ItsTonyMei/6wd-follower-esp32-openmv/STM32_Solo/STM32引脚定义图.jpg

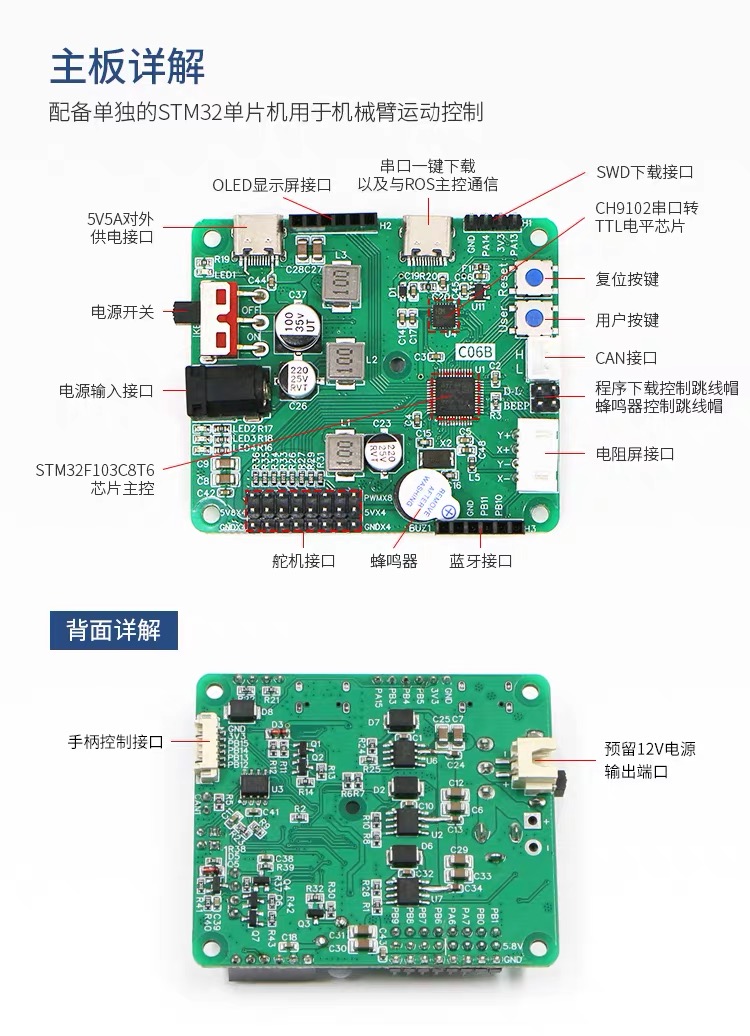
STM32_Solo/STM32引脚定义图.jpg
