ItsTonyMei/6wd-follower-esp32-openmv/STM32_Solo/C06B主板原理图_分析.md

# C06B 主板原理图 — 完整分析文档

> **元数据**
> - 文件名：C06B主板原理图.pdf
> - 页数：1 页 (Sheet 1/1)
> - 版本：REV 1.0
> - 作者：minibalance
> - 日期：2021-05-13
> - 图纸尺寸：1500 × 1300.5 pts
> - 生成工具：jsPDF 0.0.0
>
> **分析方法说明**：本文档通过 `pdftotext -layout` 提取 PDF 文本后人工判读。原理图由 EDA 工具导出为 jsPDF，pdftotext 提取结果为 ASCII-art 布局文本，元件名和网络名的空间位置近似反映原图布局，但存在偏移。**以下内容的置信度分级**：
> - ✅ 高置信度：直接标注文字（芯片型号、网络名如 3V3/GND/5V、功能块标签、"板载5V电路"等）
> - ⚠️ 中置信度：通过空间邻近关系推断的连接（如 MCU 引脚→外设接口的具体 pin 号）
> - ❌ 低置信度：涉及多位号交叉对照的连接（建议对照 PCB 或原始 PDF 确认）

---

## 1. 系统总览

C06B 是一块基于 **STM32F103C8T6**（或同系列 48 脚 LQFP 封装）的主控板，集成了多路电源、USB-C 通信/供电、CAN 总线、蓝牙、OLED 显示、PS2 手柄、8 路舵机驱动、蜂鸣器、轻触按键等功能。原理图采用 7 列网格布局（A-F 行 × 1-7 列），便于在单页中容纳所有模块。

**主控芯片识别依据**：
- 48 脚 LQFP 封装（VSS_1@23, VDD_1@24, VSS_2@35, VDD_2@36, VSS_3@47, VDD_3@48）
- PA0-PA15, PB0-PB15, PC13-PC15 引脚分布符合 STM32F103Cx 系列
- BOOT0@44, BOOT1/PB2@20, NRST@7
- OSCIN/OSCOUT (PD0/PD1) @5-6，外接 8MHz 晶振 + 22pF 负载电容
- VBAT@1 外接 3V3（非电池供电）

---

## 2. 电源树 (Power Tree)

### 2.1 输入电源

| 来源 | 接口 | 电压 | 备注 |
|---|---|---|---|
| DC 母座 | DC-005A-20A (J3) | 外部直流输入 | 经电源开关 (CN1: VIN → VIN_SW) |
| USB-C #1 | USBC1 (USB3.1C16PFSMT) | 5V VBUS | 支持 USB PD? (有 CC1/CC2 引脚) |
| USB-C #2 | USBC3 (USB3.1C16PFSMT) | 5V VBUS | 同上 |

**电源开关**：CN1 (2.54-2P WT) — VIN 经开关后输出 VIN_SW，控制整板供电。

### 2.2 DC-DC 降压电路 (3 路 RT8279GSP)

C06B 使用 **3 颗 Richtek RT8279GSP** 同步降压转换器，分别输出 3 路独立电压：

| 编号 | 输出 | 电感 | 备注 | 用途 | 位置 |
|---|---|---|---|---|---|
| U2 | **5V** (板载5V电路) | L1, 6.8μH | 反馈网络在列5，原文可见 R10=12.4k(1%), R1=10k(1%), R28=3.16k。注意：10k/3.16k 按 RT8279 Vref=0.808V 算出约 3.4V 非 5V——这些可能为补偿 RC 网络 (Rcomp+10nF)，不是反馈分压电阻。实际反馈电阻值需对照 PCB 或更高清原理图确认。 | 主系统 5V 供电 | 列 5 上部 |
| U7 | **5.8V** (板载5.8V电路) | L2, 6.8μH | R2=10k(1%), R6=10k(1%), R7=1k(1%) 在原文中可见于列2区域。同上，具体反馈分压值待确认。 | 舵机电源 | 列 2 上部 |
| U6 | **5V5A** (树莓派5V电路) | L3, 6.8μH | R24=10k(1%), R25=3.16k, R19=1k 可见于列1区域。同上。 | 外部大电流 5V 输出 | 列 1 下部 |

**典型外围**（每路相同）：
- 输入电容：22μF/25V × 2 + 4.7μF + 0.1μF
- 输出电容：22μF/25V × 2 + 0.1μF
- 输出滤波：磁珠 FB1/FB2/FB (用于 EMI)
- EN 引脚：使能控制（具体连接取决于电路）
- 续流二极管：SS54 (Schottky, 5A/40V)

**RT8279GSP 封装**：SOP-8 (EP)，带底部散热焊盘 (PAD)

### 2.3 LDO 电路

| 编号 | 芯片 | 输入 | 输出 | 用途 |
|---|---|---|---|---|
| U11 | RT9013-33GB | 5V (经 F1 自恢复保险) | **3V3** | MCU 及数字电路供电 |
| - | - | VIN_SW | 3V3 (经 LDO) | 另一路 3V3? |

> **F1**：BSMD0603-050-6V，0603 封装 500mA 自恢复保险丝，保护 5V→3.3V LDO 输入。

**3.3V 保护**：
- D8：SMBJ3.3A TVS 管，防止 3.3V 总线上过压/ESD

### 2.4 电源滤波/去耦

- 各 DC-DC 输出端均有 **220μF/16V** 大容量电解电容 (C10/C26)
- 各模块就近放置 0.1μF + 10μF 去耦
- C13/C29/C33/C34/C48: 22μF/25V 输入滤波
- C12: 22μF/25V

### 2.5 输出接口

- **H4-H7** (HDR-F-2.54_1x3 × 4)：**5V 输出**，信号来自 PB6-PB9（经 220Ω 限流电阻 R26/R27/R29/R31）
- **H8-H11** (HDR-F-2.54_1x3 × 4)：**5.8V 舵机接口**，信号来自 PB0/PB1/PA6?/PA7?（经 220Ω 限流电阻 R34/R35/R36）

---

## 3. MCU 引脚分配 (STM32F103C8T6)

### 3.1 按功能分组

#### 系统/时钟/复位
| 引脚 | 功能 | 连接 |
|---|---|---|
| PB2/BOOT1 (20) | BOOT1 | 下拉到 GND? |
| BOOT0 (44) | BOOT0 | 经 R11 (1k) 下拉 + CH9102F 控制 |
| NRST (7) | 复位 | 复位按键 (原文标注"TS按键"+"复位按键"), 经 R23 (10k) 上拉到 3V3 + CH9102F RST# |
| OSCIN/PD0 (5) | 8MHz 晶振 | X2 (8MHz) + C16 (22pF) → GND |
| OSCOUT/PD1 (6) | 8MHz 晶振 | X2 (8MHz) + C15 (22pF) → GND |
| VBAT (1) | 备份电源 | 接 3V3 (非电池) |
| VDDA (9) | 模拟电源 | 接 3V3，经 L5 (120Ω 磁珠) + C5 (0.1μF) |
| VSSA (8) | 模拟地 | GND |

#### 串口 / 调试
| 引脚 | 功能 | 连接 |
|---|---|---|
| PA9 (30) | USART1_TX | → CH9102F RXD (串口通信) |
| PA10 (31) | USART1_RX | → CH9102F TXD (串口通信) |
| PA13 (34) | SWDIO | → SWD 接口 (H1 header4) |
| PA14 (37) | SWCLK | → SWD 接口 (H1 header4) |

#### CAN 总线
| 引脚 | 功能 | 连接 |
|---|---|---|
| PA11 (32) | CAN_RX | → VP230 (U3) pin 4 (R) |
| PA12 (33) | CAN_TX | → VP230 (U3) pin 1 (D) |

#### OLED 显示屏 (SPI)
| 引脚 | 功能 | 连接 |
|---|---|---|
| PB3 (39) | SPI1_SCK | → OLED (H2-5) |
| PB4 (40) | SPI1_MISO | → OLED (H2-3) |
| PB5 (41) | SPI1_MOSI | → OLED (H2-2 附近) |
| PA15 (38) | CS 或 DC | → OLED (H2-6) |
| - | 3V3 | → OLED 供电 |
| - | GND | → OLED 地 |

> **H2 接口** (6P排母)：从 pdftotext 可确认的顺序为 1=GND, 2=3V3(及 PB5 附近), 3=PB4, 5=PB3, 6=PA15。Pin 4 = GND? (原文在 pin 4 位置附近有 GND 标注，但 OLED pin 4 为 GND 不寻常，需对照 PCB 实物确认)。注意 PB13/PB14/PB15 不在此接口——它们连接 PS2 手柄。

#### 蓝牙模块
| 引脚 | 功能 | 连接 |
|---|---|---|
| PB10 (21) | - | → 蓝牙 (H3-5) |
| PB11 (22) | - | → 蓝牙 (H3-3) |
| - | 5V | → 蓝牙供电 |

> **H3 接口** (6P排母)：从 pdftotext 可确认 1=5V, 3=PB11, 5=PB10。Pin 2、4、6 的 MCU 引脚在 pdftotext 中位置模糊（C18 0.1μF 去耦电容在 pin 2 附近），需对照 PCB 实物确认。注意 PA15 不在此接口——它在 H2 (OLED)。PA6 在原文中出现在舵机区域附近，未明确连接到 H3。

#### PS2 手柄
| 引脚 | 功能 | 连接 |
|---|---|---|
| PB12 (25) | PS2 DATA? | → CN4 (HX12501-6AWB)-6 |
| PB13 (26) | PS2 CMD? | → CN4-5 |
| PB14 (27) | PS2 CLK? | → CN4-4 |
| PB15 (28) | PS2 ATTN? | → CN4-3? |
| - | 5V / GND | → CN4 供电 |

> CN4 (HX12501-6AWB, 6P)：原文可确认 PB12→pin6, PB14→pin4，PB13、PB15 分别出现在 pin5、pin3 附近（pdftotext 位置有偏移，建议对照 PCB 确认）。Pin 1-2 推测为供电 (5V/GND)。标准 PS2 引脚: 1=DATA, 2=CMD, 3=GND, 4=VCC, 5=CLK, 6=ATTN。实际对应关系需看 PCB 走线。

#### 按键
| 引脚 | 功能 | 连接 | 说明 |
|---|---|---|---|
| PA5 (15) | TS 按键 | TS-按键, 经 R9 (10k) 上拉 3V3 | 原文标注"TS-按键"，可能为轻触按键 |
| PA11 (32) | 用户按键 | 用户按键, C20(100nF)+C19(1μF) 滤波 | 原文标注"用户按键" |
| PA3 (13) | KEY3 | KEY3 (H13: K2-3.6×6.1_SMD) | 轻触开关，一端接 PA3，一端 GND |

> 原文中 SW2 位号出现在列 3 区域，带 C11(0.1μF) 去抖，但到 PA5 或 PA11 的具体对应关系在 pdftotext 中无法精确判定，建议对照原始 PDF 实物照片确认。

#### LED
| 引脚 | 功能 | 连接 | LED |
|---|---|---|-----|
| PA4 (14) | LED 控制 | 经 R17 (1k) → LED2 (蓝色LED) → 3V3 | 低电平点亮 |
| PA12 (33) | LED 控制 | 经 R18 (1k) → LED3 (红色LED) → 3V3 | 低电平点亮 |

#### 蜂鸣器
| 引脚 | 功能 | 连接 |
|---|---|---|
| PA0 (10) | BUZZER | 经 R40 (1k) → Q3 (S8050) 基极 → 驱动 BUZ1 (SEA-12085 蜂鸣器) |

#### 舵机控制 (8 通道)

原理图标注 "8路舵机接口"。共有 8 个 HDR-F-2.54_1x3 插座，分为两组：

**5V 输出组 (H4-H7)**：供电 5V，信号来自：
| 通道 | 引脚 | 串联电阻 |
|---|---|---|
| H4 信号 | PB6? | R26 (220R) |
| H5 信号 | PB7? | R27 (220R) |
| H6 信号 | PB8? | R29 (220R) |
| H7 信号 | PB9? | R31 (220R) |

**5.8V 舵机组 (H8-H11)**：供电 5.8V，信号来自：
| 通道 | 引脚 | 串联电阻 |
|---|---|---|
| H8 信号 | PB0 | R34 (220R) |
| H9 信号 | PB1 | R35 (220R) |
| H10 信号 | PA6 或 PBx? | R36 (220R) |
| H11 信号 | PA7 或 PBx? | (220R) |

每个接口为 HDR-F-2.54_1x3（GND / 5V或5.8V / Signal），信号线串联 220Ω 保护电阻。
> 注意：PB6-PB9 到 H4-H7 的对应关系、以及 H10/H11 的信号源在 pdftotext 中无法精确定位（信号名和电阻位号在 ASCII 网格中有偏移），强烈建议对照 PCB 或原始 PDF 确认。

#### 其他 GPIO
| 引脚 | 功能 | 连接 |
|---|---|---|
| PA1 (11) | GPIO | 经 R7 (1k, 1%) 下拉? |
| PA2 (12) | GPIO | 经 R39 (1k) → Q4 (SS8550) 基极 |
| PA6 (16) | GPIO/舵机? | 原文出现在舵机 H8-H11 区域附近，可能为舵机信号之一 |
| PA7 (17) | GPIO/舵机? | 原文出现在舵机区域 (线 207)，可能为舵机信号之一 |
| PA8 (29) | GPIO | 经 R38 (1k) → Q5 (SS8550) 基极 |
| PC13 (2) | GPIO | 经 R37 (1k) → Q7 (S8050) → CN2? (XH-4AW_C2908613) |
| PC14 (3) | GPIO | 经 R41 (10k) 上拉到 3V3? |
| PC15 (4) | GPIO | 经 R43 (1k) → Q6 (S8050) 基极 |

---

## 4. USB 转串口 & 一键下载电路

### 4.1 CH9102F (U4)

**芯片**：WCH CH9102F — USB 转高速串口芯片，QFN-24 封装

| CH9102F 引脚 | 连接 |
|---|---|
| UD+ (3) | USBD+ → MCU? |
| UD- (4) | USBD- → MCU? |
| RXD (14) | → PA10 (MCU USART1_RX) |
| TXD (15) | → PA9 (MCU USART1_TX) |
| RTS (18) | → 一键下载电路 |
| DTR (20) | → 一键下载电路 |
| CTS (17) | → ? |
| DSR (21) | → ? |
| DCD (22) | → ? |
| RI (23) | → ? |
| VIO (5) | → 3V3 (IO 电压) |
| V3 (6) | → C3 (0.1μF) → GND (内部 LDO 退耦) |
| VDD5 (7) | → 5V (USB VBUS) |
| VBUS (9) | → 5V |
| RST# (10) | → MCU NRST (经 1N4148 D1?) |

**USB-C 连接**：
- USBC1 (USB3.1C16PFSMT): USBD+/USBD- → CH9102F UD+/UD-
- 支持 CC1/CC2 引脚（USB PD? 但只连到 GND）

### 4.2 一键下载电路 (Auto-Download)

经典的一键下载电路，实现无需手动切换 BOOT0/RESET：

- **Q1** (SS8550 PNP)：控制 BOOT0 — 集电极接 BOOT0 (经 R12 1k)，基极经 R14 (1k) 接 DTR
- **Q2** (SEBT8050 NPN?/PNP?)：控制 NRST — 集电极接 NRST，基极经 R13 (10k) 接 RTS
- **D3** (1N4148)：隔离 Q2 和手动复位按键

**工作原理**：
1. 下载软件拉低 DTR → Q1 导通 → BOOT0 拉高
2. 下载软件拉低 RTS → Q2 导通 → NRST 拉低 → MCU 复位
3. 释放 RTS → MCU 从复位释放，检测到 BOOT0=高 → 进入 ISP 模式
4. 下载完成后复位，BOOT0 恢复低电平 → 从 Flash 启动

---

## 5. CAN 总线电路

### 5.1 VP230 (U3)

**芯片**：TI VP230 — 3.3V CAN 收发器，SOP-8 封装

| 引脚 | 连接 |
|---|---|
| 1 (D) | ← PA12 (MCU CAN_TX) |
| 2 (GND) | GND |
| 3 (VCC) | 3V3 |
| 4 (R) | → PA11 (MCU CAN_RX) |
| 5 (VREF) | 经 C41 (0.1μF) → GND |
| 6 (CANL) | → CAN 总线低 |
| 7 (CANH) | → CAN 总线高 |
| 8 (RS) | 经 R20 (0Ω) → GND (高速模式) |

**CAN 终端电阻**：R5 (120Ω) 在 CANH-CANL 之间（PCB 上默认焊接）
**共模滤波**：C19 (100nF) + C20 (1μF) CANH/CANL 对地
**总线保护**：未发现 TVS 管（可考虑添加 PESD1CAN 等）

**CAN 接口**：Header 2 (2.54mm 间距排针): 1=CANH, 2=CANL

---

## 6. 显示 & 人机交互

### 6.1 OLED 显示屏

- **接口类型**：6P 排母 (H2)，SPI 协议
- **典型屏**：0.96" 128x64 SSD1306 OLED (SPI 模式)
- **已确认连接**：1=GND, 2=3V3(供电), 3=PB4(SPI1_MISO), 5=PB3(SPI1_SCK), 6=PA15(CS/DC)。PB5(SPI1_MOSI) 在 pin 2 附近出现。Pin 4 附近原文标注 GND——需对照 PCB 确认。
- **注意**：PB13/PB14/PB15 不连接 OLED，它们连接 PS2 手柄 (CN4)。

### 6.2 电阻触摸屏

原理图标注 "电阻屏"（电阻式触摸屏），但未见独立触摸控制器 IC。可能：
- 通过 MCU ADC 直接读取触摸坐标
- 或使用外部触摸控制芯片（未在原理图中明确标出）

### 6.3 用户按键

| 按键 | 类型 | MCU 引脚 | 说明 |
|---|---|---|---|
| TS-按键 | 轻触开关 | PA5 | 经 R9 (10k) 上拉 3V3 |
| 用户按键 | 轻触开关 | PA11 | 带 C20(100nF)+C19(1μF) 滤波 |
| KEY3 | 轻触 | PA3 | 第三个用户按键，K2-3.6×6.1_SMD |

> 原文标注"TS-按键"和"TS按键"，"TS"通常为 Tactile Switch (轻触开关) 的缩写，而非电容式触摸感应按键。

### 6.4 LED 指示灯

| LED | 颜色 | 控制 | 说明 |
|-----|---|---|---|
| LED1 | 电源指示 | 直接接电源(5V?) | 上电常亮 |
| LED2 | 蓝色 | PA4 (低有效) | 用户可编程 |
| LED3 | 红色 | PA12 (低有效) | 用户可编程 |
| LED4 | 3V3 指示 | 直接接 3V3 | 3.3V 电源指示 |

### 6.5 蜂鸣器

- **型号**：SEA-12085 (电磁式有源蜂鸣器, 12mm, 85dB)
- **驱动**：Q3 (S8050 NPN) 开关驱动
  - 基极限流：R40 (1k)
  - 续流保护：D5 (1N4148)
  - 电源去耦：C39 (100nF)

---

## 7. 通信接口汇总

| 接口 | 协议 | 硬件 | MCU 引脚 |
|---|---|---|---|
| USB-C (USBC1) | USB 2.0 FS | CH9102F | PA9/PA10 (串口透传) |
| USB-C (USBC3) | USB 2.0? | 直连 MCU? | PA11/PA12? (USB D+/D-) |
| CAN | CAN 2.0B | VP230 | PA11(RX)/PA12(TX) |
| SWD | SWD | 4P 排针 | PA13(SWDIO)/PA14(SWCLK) |
| 串口 | UART | CH9102F | PA9(TX)/PA10(RX) |
| OLED | SPI (H2) | 6P 排母 | PB3(SCK), PB4(MISO), PB5(MOSI), PA15(CS/DC) |
| 蓝牙 | UART? (H3) | 6P 排母 | PB10, PB11 (+ 2 个未确认引脚) |
| PS2 手柄 | PS/2 (CN4) | 6P 连接器 | PB12-PB15 |
| I2C? | I2C | - | PB6(SCL)/PB7(SDA)? (标准重映射) |

> **注意**：PA11/PA12 同时用于 CAN (VP230) 和 USBC3 USB D+/D-。这是互斥的——焊接 CAN 收发器则不能使用 USB Device 功能，反之亦然。需要确认 PCB 实际焊接选择。

---

## 8. 关键设计注意事项

### 8.1 电源设计亮点
- ✅ 3 路独立 DC-DC，舵机电源 (5.8V) 与数字电路 (5V) 分离，防止舵机堵转拉低 MCU 电压
- ✅ 每路 DC-DC 输出均有磁珠滤波 (FB1/FB2/FB)，降低高频噪声
- ✅ LDO 输入端自恢复保险丝 (F1)，防止 3.3V 短路损坏
- ✅ 3.3V 总线 TVS 保护 (SMBJ3.3A)
- ⚠️ 5V/5.8V 输出无短路保护（仅串 220Ω 电阻，大电流时会烧毁）

### 8.2 布局分析
- 原理图采用 7 列网格，左右分区：
  - **左侧 (列 1-2)**：电源电路（3 路 DC-DC、LDO、DC 输入)
  - **中部 (列 3-4)**：MCU + 晶振 + 复位
  - **中右 (列 5)**：CH9102F 串口、CAN、USB-C
  - **右侧 (列 6-7)**：舵机接口、按键、蜂鸣器、外设接口

### 8.3 潜在问题
1. **PA11/PA12 引脚冲突**：CAN 和 USB 共用，只能二选一
2. **舵机限流电阻 220Ω**：如果舵机信号线需要较大驱动电流，220Ω 可能影响信号边沿
3. **无 ESD 保护**：USB-C、CAN、舵机接口未发现 TVS/ESD 保护器件（除 3.3V 总线外）
4. **CAN 终端电阻固定焊接**：R5 (120Ω) 若在 PCB 上默认焊接，多节点通信时需要拆除
5. **振荡器**：使用外部 8MHz 晶体而非有源晶振，对 PCB 走线长度敏感

### 8.4 推荐修改（给 Claude 的建议）
- 在 CANH/CANL 上增加 PESD1CAN 或类似 CAN 专用 TVS
- 在舵机 5.8V 输出增加 PTC 自恢复保险丝
- USB D+/D- 增加 USBLC6-2 等 ESD 保护
- 考虑将 220Ω 舵机信号电阻改为 33-100Ω

---

## 9. BOM 关键元器件速查

| 位号 | 型号 | 封装 | 功能 |
|---|---|---|---|
| U1 | STM32F103C8T6 | LQFP-48 | 主控 MCU |
| U2, U6, U7 | RT8279GSP | SOP-8 (EP) | DC-DC 降压 |
| U3 | VP230 | SOP-8 | CAN 收发器 |
| U4 | CH9102F | QFN-24 | USB 转串口 |
| U11 | RT9013-33GB | SOT-23-5? | 5V→3.3V LDO |
| Q1,Q4,Q5 | SS8550 | SOT-23 | PNP 三极管 |
| Q2 | SEBT8050 | SOT-23 | NPN 三极管 |
| Q3,Q6,Q7 | S8050 | SOT-23 | NPN 三极管 |
| D2,D7 | SS54 | SMC/DO-214AB | 肖特基续流二极管 |
| D6 | P6SMB550A/SS54 | SMB | TVS/肖特基 |
| D8 | SMBJ3.3A | SMB | 3.3V TVS |
| D1,D3,D5 | 1N4148 | SOD-123? | 信号二极管 |
| L1,L2,L3 | 6.8μH | SMD 功率电感 | DC-DC 储能 |
| L5 | 120Ω | 0603/0805 | 磁珠 (模拟电源) |
| X2 | 8MHz | 49S/SMD 3225 | 主晶振 |
| F1 | BSMD0603-050-6V | 0603 | 500mA PTC 保险丝 |
| BUZ1 | SEA-12085 | DIP-12mm | 有源蜂鸣器 |
| SW1,SW2 | 轻触按键 | SMD | 用户按键 (SW2 连接未确认，见 §6.3) |
| KEY3 | K2-3.6×6.1_SMD | SMD | 轻触按键 |
| J3 | DC-005A-20A | DIP | DC 电源插座 |
| CN4 | HX12501-6AWB | DIP-6 | PS2 手柄插座 |

---

## 10. 开发建议

### 10.1 固件开发
- **HAL 库选择**：推荐 STM32CubeMX 生成 STM32F103C8Tx HAL 代码
- **时钟配置**：HSE 8MHz → PLL 9x → 72MHz SYSCLK
- **调试接口**：SWD (PA13/PA14)，使用 ST-Link v2 或 CMSIS-DAP

### 10.2 引脚重映射注意事项
- CAN 使用 PA11(RX)/PA12(TX)，这是默认复用功能，无需重映射
- 如果使用 I2C，PB6/PB7 需要开启 AFIO 重映射
- SPI1 使用 PB3-PB5 需要禁用 JTAG (仅保留 SWD)

### 10.3 上电默认状态
- PA11/PA12 默认浮空，如果 CAN 收发器已焊接，总线上会呈现隐性电平 (约 2.5V)
- PB3 (JTDO) 默认有内部上拉，需要在代码中重新配置

---

> **文档版本**：v1.1 (勘误修正版)
> **分析工具**：pdftotext -layout + 人工逐行对照验证
> **分析日期**：2026-05-27
> **原理图文件**：/home/tonymei/桌面/C06B主板原理图.pdf
