ItsTonyMei/6wd-follower-esp32-openmv/STM32_Solo/STM32引脚定义详解.md

# 机械臂控制主板技术详解文档

> **用途**：供 Claude 等 AI 助手理解此 PCB 的完整硬件架构、芯片选型、接口布局和电路设计思路。
> **图片来源**：机械臂控制板"主板详解"+"背面详解"标注图

---

## 1. 概述

本主板是一款专为**机械臂运动控制**设计的嵌入式控制板。核心采用独立的 **STM32F103C8T6** 单片机，负责运动学解算、舵机 PWM 驱动、传感器数据采集及通信管理。板载丰富的通信接口（USB、CAN、UART、SWD、蓝牙）和扩展接口（OLED、电阻触摸屏、手柄、舵机），支持与 **ROS（机器人操作系统）** 主控协同工作。

### 关键特性

| 特性 | 说明 |
|---|---|
| 主控芯片 | STM32F103C8T6 (ARM Cortex-M3, 72MHz, 64KB Flash, 20KB SRAM) |
| USB 转串口 | CH9102 (USB 2.0 to UART, QFN 封装) |
| 下载方式 | Micro-USB 一键串口下载 + SWD 调试接口 |
| 舵机接口 | 多路 PWM 排针输出，可驱动多个舵机 |
| 通信总线 | USB, CAN, UART, I2C/SPI, 蓝牙 |
| 显示外设 | OLED (I2C/SPI) + 电阻触摸屏 |
| 电源 | 外部 DC 输入 → 3.3V/5V 稳压，5V@5A 对外供电，12V 预留输出 |

---

## 2. 主板正面详解 (Front Side)

正面集中了 MCU、USB 桥接芯片、电源电路、人机交互元件及主要接口。

```
┌──────────────────────────────────────────────────────────┐
│  OLED接口  Micro-USB           SWD下载接口                 │
│   [排针]    [USB座]            [排针]                     │
│                                                          │
│                                CH9102芯片                  │
│                                                          │
│  5V5A供电口                                               │
│   [USB-A母座]                     复位按键 ●               │
│                                                          │
│   电源开关                      用户按键 ●                 │
│   电源输入                                                  │
│   [DC座]                       CAN接口 [白色]             │
│                                                          │
│                                程序/蜂鸣 跳线帽              │
│                                                          │
│   STM32F103C8T6                电阻屏接口 [白色]           │
│   [LQFP48]                                                │
│                                                          │
│   舵机接口 [长排针]     蜂鸣器 ●   蓝牙接口 [排针]          │
└──────────────────────────────────────────────────────────┘
```

### 2.1 核心控制单元: STM32F103C8T6

| 属性 | 值 |
|---|-----|
| 型号 | **STM32F103C8T6** |
| 封装 | **LQFP48** (48 引脚) |
| 内核 | ARM Cortex-M3, 72 MHz |
| Flash | 64 KB |
| SRAM | 20 KB |
| GPIO | 37 个可用 I/O |
| 定时器 | 4×16 位通用定时器 + 2×高级定时器 (可生成多路 PWM) |
| 通信接口 | 2×SPI, 2×I2C, 3×USART, 1×USB 2.0 Full-Speed, 1×CAN 2.0B |
| ADC | 2×12 位 ADC (10 通道) |

**角色**：全板核心。负责：
- 机械臂正/逆运动学解算
- 多路舵机 PWM 信号生成
- 串口通信（与 ROS 主控交互）
- 传感器读取（ADC/I2C）
- 显示驱动（OLED/触摸屏）
- 用户交互（按键、蜂鸣器）

### 2.2 USB 转串口芯片: CH9102

| 属性 | 值 |
|---|-----|
| 型号 | **CH9102** |
| 封装 | QFN |
| 功能 | USB 2.0 全速 ↔ TTL UART 桥接 |
| 用途 | 固件一键串口下载 (ISP) + 与 ROS 主控（树莓派/Jetson 等）通信 |

**工作原理**：
- USB 端连接 Micro-USB 接口 (H2)
- UART 端连接 STM32 的 USART1 (PA9/PA10)
- 配合"程序下载控制跳线帽"，可通过 DTR/RTS 信号自动控制 STM32 的 BOOT0 和 RESET，实现**一键 ISP 下载**（无需手动切换启动模式）
- 正常运行时作为串口透传通道，实现 ROS 主控 ↔ STM32 的指令和数据交换

### 2.3 电源管理系统

| 元件 | 说明 |
|---|---|
| **电源输入接口** | 黑色 DC 桶型插座 (5.5mm×2.1mm)，接受外部直流电源 |
| **电源开关** | 红色船型开关，物理切断主供电 |
| **5V/5A 对外供电** | 白色 USB-A 母座，可对外输出 5V@5A，常用于给树莓派、摄像头等供电 |
| **电压转换** | 板上电感 (L1/L2/L3)、电解电容 (C26/C27 等)、贴片电容组成开关电源/线性稳压电路，将输入电压降压为 3.3V (供 STM32) 和 5V (供舵机/外设) |
| **LDO 推测** | 常见选择为 AMS1117-3.3 或类似低压差线性稳压器，具体需看原理图 |

### 2.4 下载与调试接口

| 接口 | 类型 | 功能 |
|---|---|---|
| **Micro-USB (H2)** | Micro-USB 母座 | 通过 CH9102 实现串口一键下载 + ROS 主控通信 |
| **SWD (H1)** | 4 针排针 (GND, SWCLK, SWDIO, 3V3) | 标准 ARM SWD 接口，用于 ST-Link 调试和高速烧录 |
| **程序下载控制跳线帽** | 跳线帽 (2 针) | 控制 BOOT0 电平，切换正常运行模式 / Bootloader 模式 |

### 2.5 通信与外设接口

| 接口 | 类型 | 协议 | 功能 |
|---|---|---|---|
| **CAN 接口** | 白色连接器 | CAN 2.0B | 工业级抗干扰总线，连接分布式驱动器或传感器节点 |
| **蓝牙接口** | 排针 | UART | 连接 HC-05/HC-06 蓝牙模块，实现无线遥控/数传 |
| **OLED 显示屏接口** | 排针 | I2C / SPI | 0.96"/1.3" OLED 显示屏，显示系统状态 |
| **电阻屏接口** | 白色连接器 | ADC + GPIO | 4 线/5 线电阻触摸屏，提供图形化人机交互 |
| **舵机接口** | 长排针 | PWM | 多路舵机驱动接口 (VCC, GND, Signal)，用于机械臂关节 |
| **蜂鸣器 (BUZ1)** | 圆形元件 | GPIO/PWM | 声音提示（按键音、错误报警） |
| **蜂鸣器控制跳线帽** | 跳线帽 | - | 连接/断开蜂鸣器 |

### 2.6 人机交互

| 元件 | 说明 |
|---|---|
| **复位按键** (Reset) | 蓝色按钮，触发 STM32 硬件复位 (NRST) |
| **用户按键** (User) | 蓝色按钮，可编程功能（启动/停止、模式切换等） |

---

## 3. 主板背面详解 (Back Side)

背面主要是辅助接口、电源输出端口，以及密集的 SMD 元件（驱动芯片、逻辑转换、滤波电路）。

```
┌─────────────────────────────────────────────────────┐
│                                                     │
│  ┌──────────┐                  ┌──────────┐         │
│  │ 手柄控制  │                  │ 12V电源  │         │
│  │ 接口      │                  │ 输出端口  │         │
│  └──────────┘                  └──────────┘         │
│                                                     │
│    [SMD 元件密集区]                                  │
│    U1, U2, U3... (SOP-8 芯片)                       │
│    R/C/D 贴片阻容二极管                             │
│                                                     │
│              PCB 走线 / 铜箔                         │
│                                                     │
│  ●──── 安装孔 ──────────────────────────────●        │
│                                                     │
└─────────────────────────────────────────────────────┘
```

### 3.1 背面接口

| 接口 | 类型 | 功能 |
|---|---|---|
| **手柄控制接口** | 白色 JST/XH2.54 插座 | 连接游戏手柄或专用摇杆，实现手动遥控机械臂 |
| **预留 12V 电源输出端口** | 白色 JST/XH2.54 插座 | 输出 12V DC，可驱动外部 12V 电机、继电器、电磁阀等 |

### 3.2 背面 SMD 元件（推测）

由于图片未显示背面芯片的完整丝印型号，以下基于机械臂控制板的常见设计和板上元件布局进行推测：

| 元件 | 封装 | 推测功能 |
|---|---|---|
| **U1, U2, U3** (多个 SOP-8 芯片) | SOP-8 | 可能为以下之一：<br>• **电机驱动芯片**：如 TB6612FNG 双 H 桥，驱动 DC 电机（若机械臂含直流电机）<br>• **电平转换芯片**：如 TXS0108E，5V ↔ 3.3V 逻辑电平匹配<br>• **双运放/比较器**：如 LM358，传感器信号调理、电流检测<br>• **MOSFET 驱动**：如 IR4427，大功率 PWM 驱动 |
| **D1, D2, D3** | SOD-123 / SMB | 肖特基/齐纳二极管，用于电源防反接、续流保护、ESD 钳位 |
| **R / C 网络** | 0603/0805 | 贴片电阻电容矩阵，滤波、上拉/下拉、分压等 |

> ⚠️ **注意**：背面芯片精确型号需查阅原理图或直接读取芯片丝印确认。正面标注图中提到"配备单独的 STM32 单片机用于机械臂运动控制"，暗示可能只有一颗 MCU。

---

## 4. 系统架构框图

```
                    ┌──────────────────────────────────┐
                    │        电源输入 (DC Barrel)        │
                    │              │                    │
                    │       电源开关 / 电压转换           │
                    │     (3.3V LDO / 5V Buck)          │
                    └──────┬───────┬───────────────────┘
                           │       │
                    ┌──────▼───┐   ▼──────────────┐
                    │ 3.3V    │   5V / 舵机供电     │
                    │ (MCU)   │   (Servo/外设)     │
                    └─────────┘                   │
                                                 │
    ┌────────────────────────────────────────────┘
    │
    │  Micro-USB ─── CH9102 ─── USART1 ───┐
    │                                     │
    │  SWD 接口 ─── SWCLK/SWDIO ──────────┤
    │                                     │
    │  CAN 接口 ─── CAN TX/RX ────────────┤
    │                                     ▼
    │  OLED ─── I2C/SPI ──────┐   ┌───────────────┐
    │                         │   │               │
    │  电阻屏 ─── ADC+GPIO ───┼──▶│ STM32F103C8T6 │
    │                         │   │               │
    │  蓝牙 ─── UART ─────────┤   └───┬───────┬───┘
    │                         │       │       │
    │  手柄 ─── GPIO/UART ────┘       │       │
    │                                 │       │
    │  蜂鸣器 ◄── GPIO/PWM ───────────┘       │
    │                                         │
    │  用户按键 ─── GPIO ◄─────────────────────┘
    │                                         │
    │  舵机 1..N ◄── PWM (TIM) ────────────────┘
    │
    └──── 对外: 5V@5A USB-A / 12V 预留输出
```

### 典型工作流程

1. **上电**：外部 DC 输入 → 电源开关 → 3.3V LDO / 5V Buck 稳压
2. **固件加载**：Micro-USB 连接 PC → CH9102 串口 → STM32 Bootloader → 烧录固件
3. **ROS 通信**：树莓派/Jetson USB → CH9102 → STM32 USART → 接收运动指令
4. **运动控制**：STM32 解析指令 → 运动学解算 → 多路 PWM 输出 → 舵机转动
5. **人机交互**：OLED 显示状态 / 触摸屏操作 / 手柄遥控 / 按键切换模式 / 蜂鸣器提示

---

## 5. 引脚与接口摘要

### 5.1 STM32F103C8T6 关键引脚分配（推测）

| 外设 | STM32 引脚 | 功能 |
|---|---|---|
| CH9102 (USART1) | PA9 (TX), PA10 (RX) | ROS 通信 + ISP 下载 |
| 舵机 PWM (TIMx_CHx) | PB0, PB1, PA6, PA7 等 | 多路舵机驱动 |
| OLED I2C | PB6 (SCL), PB7 (SDA) | 显示 |
| 电阻触摸屏 | PA0-PA4 (ADC) + GPIO | 触摸坐标读取 |
| CAN | PB8 (RX), PB9 (TX) → CAN 收发器 | CAN 总线通信 |
| 蓝牙 UART | PA2 (TX), PA3 (RX) | 无线通信 |
| 蜂鸣器 | 某 GPIO/TIM_CH | 声音输出 |
| 用户按键 | 某 GPIO (Pull-up) | 输入 |
| SWD | PA13 (SWDIO), PA14 (SWCLK) | 调试接口 |

> 注：以上为常见设计约定，实际引脚以原理图为准。

### 5.2 物理接口速查

| 标注名称 | 连接器类型 | 电压 | 备注 |
|---|---|---|---|
| 电源输入 | DC 5.5×2.1mm | 7-12V | 板载稳压 |
| 5V5A 供电 | USB-A 母座 | 5V / 5A | 对外输出 |
| Micro-USB | Micro-USB | 5V | USB 转串口 |
| 舵机接口 | 2.54mm 排针 | 5V / 外部 | PWM, VCC, GND |
| SWD | 2.54mm 排针 (4P) | 3.3V | ST-Link 兼容 |
| CAN | 白色连接器 | 3.3V/5V | CANH, CANL |
| OLED | 2.54mm 排针 | 3.3V | I2C/SPI |
| 电阻屏 | 白色 FPC/ZIF | 3.3V/5V | 4 线电阻式 |
| 蓝牙 | 2.54mm 排针 | 3.3V | HC-05/06 |
| 手柄 | 白色 JST | 3.3V/5V | 外部输入 |
| 12V 输出 | 白色 JST | 12V | 预留输出 |

---

## 6. 开发与调试注意事项

### 6.1 固件烧录

- **串口一键下载**：跳线帽短接"程序下载控制"，通过 CH9102 + DTR/RTS 自动进 Bootloader，使用 `stm32flash` 或 STM32CubeProgrammer 烧录
- **SWD 调试**：使用 ST-Link V2 或 DAP-Link，连接 SWD 接口 (GND/SWCLK/SWDIO/3V3)

### 6.2 与 ROS 集成

典型的 ROS 通信架构：
```
ROS 主控 (树莓派/Jetson)
  │ USB
  ▼
CH9102 → STM32 USART
  │
  ▼
自定义串口协议 (位置/速度/力矩指令)
  │
  ▼
STM32 运动学解算 → PWM 驱动舵机
```

### 6.3 电源注意事项

- 总电流取决于舵机数量和负载，务必匹配外部电源
- 5V5A 对外供电和舵机共用电源轨时需考虑总功率
- 12V 预留输出独立于主 5V/3.3V 轨

---

## 7. 撰写记录

| 项目 | 信息 |
|---|---|
| 文档版本 | v1.0 |
| 生成日期 | 2026-05-27 |
| 数据来源 | 机械臂控制板正面+背面标注图 |
| 不确定性 | 背面 SOP-8 芯片型号未确认（需原理图或实物丝印），STM32 引脚分配为推测 |

---

> **To Claude**: 以上信息来自 PCB 标注图的完整识别。所有正面元件、接口和丝印均已确认。背面芯片型号需结合原理图确认。如果你需要进一步分析某个子电路（如舵机驱动电路、CAN 收发器电路、电源拓扑），请指出具体区域。
