ItsTonyMei/6wd-follower-esp32-openmv/STM32_Solo/C06B主板原理图.pdf

PB12 25 PB13 26 PB14 27 PB15 28 PA8 29 PA9 30 PA10 31 PA11 32 PA12 33 PA13 34 VSS_2 35 VDD_2 PA14

# 板载5V电路

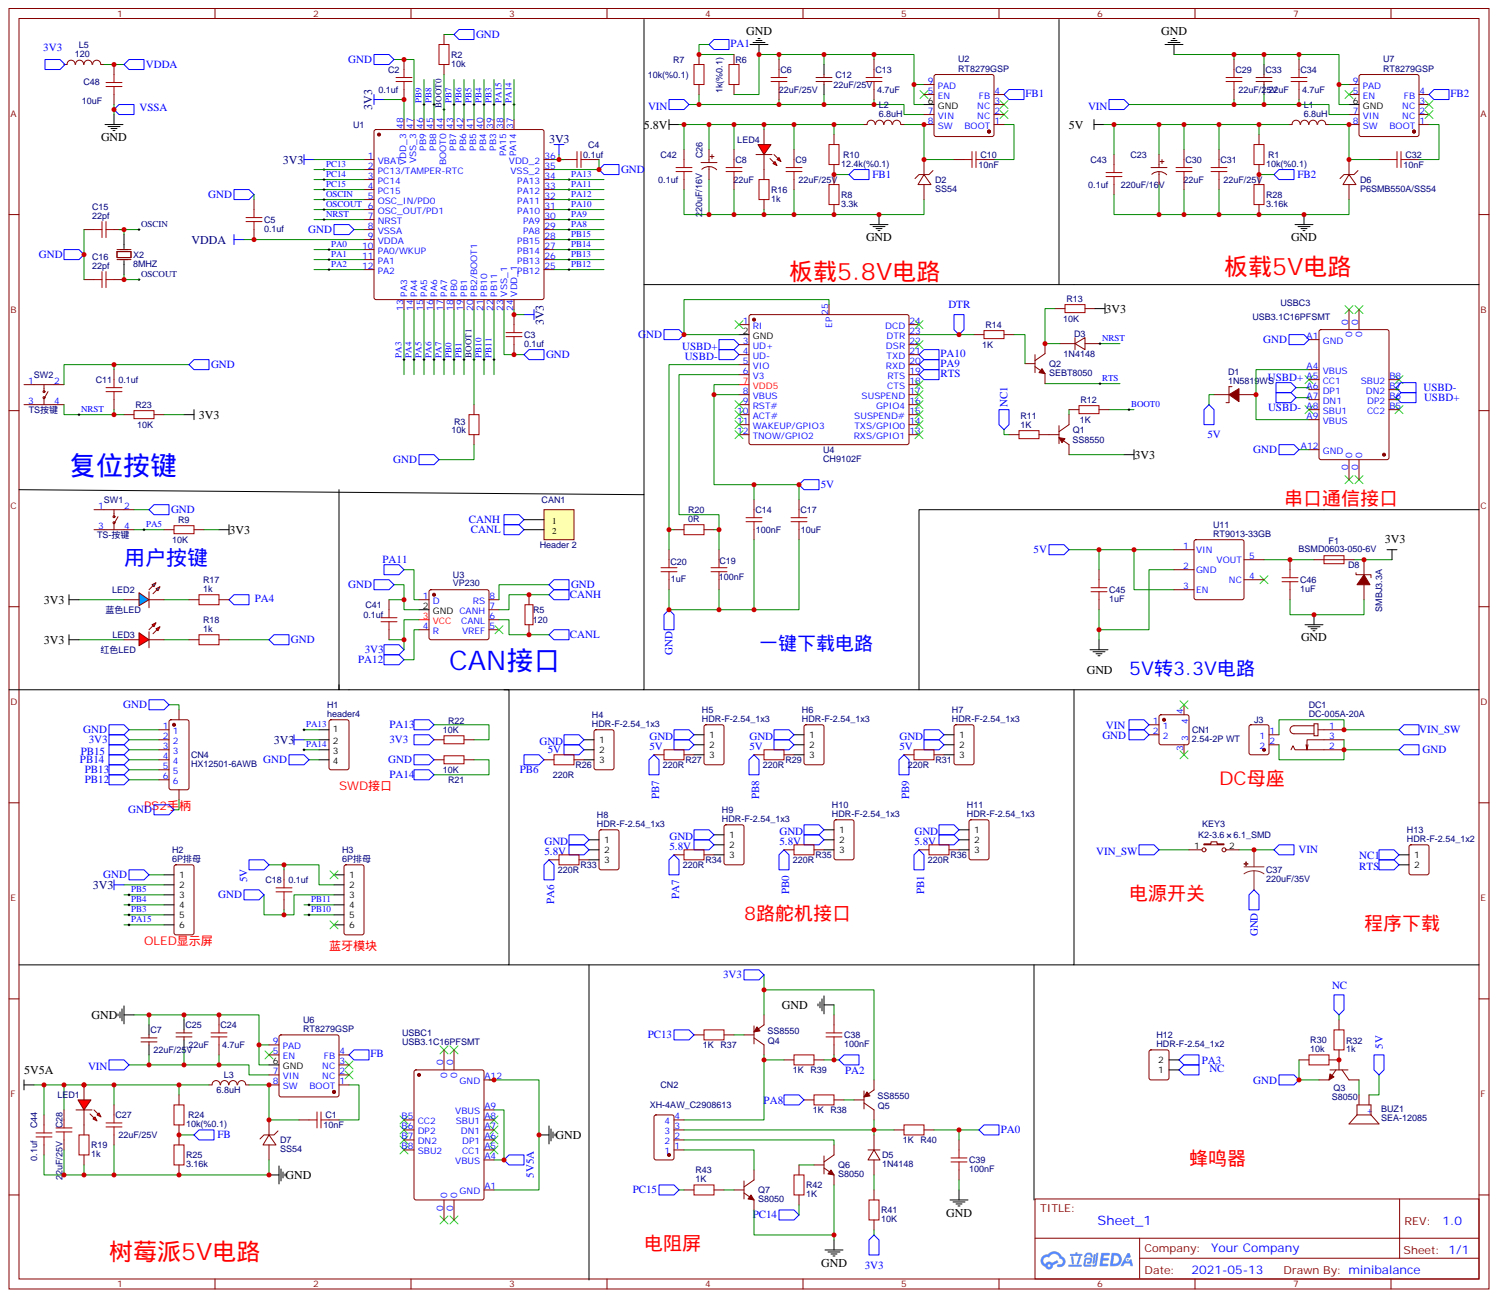
[picture p2: page 1]
