ItsTonyMei/6wd-follower-esp32-openmv/(commit log)

2026-05-26 初始版本：6轮车-UniBoard ESP32单板控制方案
2026-05-26 refactor: 仓库重整 — 清除冗余、中英文双语规范化
    核心变更:
    - DataAggregator 封装互斥锁 (lock/unlock), 消除 MotorTask/Tasks 重复代码
    - FollowLogic 直接返回 MotorCmd struct, 删除字符串协议往返和 parseFollowCmd()
    - VisionBridge 用 strtol/strtof+endptr 代替 const_cast 消除 UB
    - DataAggregator::getJson() 改用 snprintf 固定 buffer 避免 heap 碎片
    - MotorDriver 使用 Config.h MOTOR_DEAD_TIME_MS 代替本地重复常量
    - 删除死代码: turnCommand(), computeOffset(), parseFollowCmd(), 静态 lockAggregator
    - 所有注释/文档 → 中文 + 英文专业名词 (PWM, FreeRTOS, UART, YOLO 等保持英文)
    - 新增 Test/ArduinoMock.h 共享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
2026-05-26 docs: add comprehensive development roadmap for tracked vehicle migration
    8-phase roadmap covering OpenMV perception → ESP32 decision → STM32
    execution architecture with 48 trackable tasks, dependency chains, and
    6 milestones. Includes 5 independent safety shutdown paths.
2026-05-26 refactor: migrate to tracked vehicle 3-layer architecture — ESP32 config rewrite + STM32 firmware bootstrap
2026-05-26 feat: replace ultrasonic with VL53L1X ToF laser ranging — VIS protocol extension + full doc sync
    - OpenMV: integrate VL53L1X ToF distance shield (I2C addr 0x29, 40-4000mm ±1mm 50Hz)
    - VIS protocol: add optional tofDist field, backward-compatible parsing
    - ESP32 VisState: add tofDistance (mm), remove CarState leftUltrasonic/rightUltrasonic
    - Dashboard HTML: replace ultrasonic sidebars with ToF distance indicator
    - ROADMAP: Phase 6 rewritten with ToF integration, fusion algorithm, calibration plan
    - All docs synced: CLAUDE.md, Config.h, DataAggregator, VisionBridge, Tasks, ESP32_Solo.ino
    [Config.h, ESP32_Solo.ino]
2026-05-26 feat: add VL53L1X ToF distance sensor test script for OpenMV H7 Plus
    Comprehensive validation: I2C bus auto-detect (I2C2/I2C1), chip ID verify,
    100-sample continuous ranging, statistics (min/max/avg/jump), LED distance
    indicator, manual verification prompts.
2026-05-26 chore: confirm chip silkscreens, sync all docs — STM32F103C8T6 + ESP32-WROOM-32U
    - STM32: silk confirmed STM32F103C8T6 (Cortex-M3 72MHz, 64KB Flash, 20KB SRAM)
    - ESP32: silk confirmed ESP32-WROOM-32U (DevKit V1, Xtensa LX6 240MHz, 4MB Flash)
    - OpenMV N6: VL53L1X verified (I2C2, Model ID 0xEACC, 100/100 valid, 33.3Hz)
    - Removed incorrect CBT6/128KB references, corrected to C8T6/64KB
    - Added official vl53l1x.py driver to OpenMV/ for manual upload fallback
    - Updated CLAUDE.md, ROADMAP.md (Phase 0.1-0.4), Config.h, ESP32_Solo.ino,
    STM32 main.cpp, platformio.ini, test_vl53l1x.py, main.py
    [Config.h, ESP32_Solo.ino, main.cpp, main.py, test_vl53l1x.py]
2026-05-26 chore: document STM32 custom board GPIO mapping and finalize blink test
    - GPIO scan: tested all 30 accessible pins on STM32F103C8T6 custom board
    - Confirmed: PA3=BEEP (active-LOW), PA4=LED2 blue (active-LOW)
    - LED1/LED3/LED4 = power indicators (not GPIO-controlled)
    - USART1 (PA9/PA10) → CH9102, generic variant defaults to USART2, requires
    HardwareSerial override
    - Flash params: 115200 baud, sequence -dtr,rts,dtr,,,, (400ms extra delay)
    - Updated: CLAUDE.md (board details + GPIO table), ROADMAP.md (Phase 0.1),
    DevBoard描述.md (peripheral mapping), main.cpp (final blink on PA4)
2026-05-26 docs: finalize Phase 0.1 — STM32 blink test verified, update roadmap progress
2026-05-26 feat: clean ESP32 firmware — remove ultrasonic/MotorTask, verify stable boot
    - Removed: UltrasonicSensors, MotorDriver, MotorTask, Tasks (8 files)
    - Clean .ino: MainTask (VIS+FollowLogic) + WebTask (Dashboard), zero ultrasonic
    - Added ESP32_Solo/platformio.ini for CLI build
    - Chip confirmed: ESP32-D0WD-V3 rev3.1, MAC d4:e9:f4:bc:c5:3c
    - Verified: WiFi AP (Tracked Robot @ 192.168.4.1), Dashboard online, no reboot loop
    - Updated: CLAUDE.md (chip details), ROADMAP.md (Phase 0.2 status)
    [ESP32_Solo.ino]
2026-05-26 新增手机端 WiFi Dashboard，完成 ESP32 Phase 0.2 核心验证
    - 重写 index_html.h：深色主题、手机端优先、200ms 轮询 /status
    - Dashboard 面板：视觉感知（检测状态/距离/ToF/检测框）、车辆状态（动作/PWM）、系统信息
    - DataAggregator JSON 新增 sys 字段（uptime、WiFi 客户端数）
    - WiFi 密码简化为 12345678
    - 测试通过：手机连接 Tracked Robot @ 192.168.4.1，Dashboard 正常
2026-05-26 OpenMV N6 升级至 YOLOv8n NPU 推理，帧率从 ~10 提升至 45 FPS
    - 模型：/rom/yolov8n_192.tflite + YoloV8 postprocess（N6 NPU 120+ FPS 能力）
    - 实际帧率：45 FPS（QVGA→192x192 window，含绘图+ToF+VIS 开销）
    - 兼容 H7 Plus：自动降级为 YOLO-LC
    - 适配 N6 API：draw 函数使用 tuple 坐标，time.ticks_ms() 替代 pyb.millis()
    - ToF: VL53L1X @ I2C(2) 集成，距离与视觉融合估计
    - VIS 协议：100ms 间隔（N6）/ 200ms（H7），含 tofDist 字段更新 ROADMAP.md Phase 0.3
2026-05-26 OpenMV N6 使用完整 QVGA 分辨率，画面清晰 — 48 FPS
    - 移除 cam.window((192,192))，改用完整 QVGA 320x240 拍摄
    - YOLOv8n 模型自动居中裁剪到 192x192 做推理
    - 检测坐标自动映射回原图空间，绘制在清晰画面上
    - VIS 输出坐标缩放到 192x192 以兼容 ESP32 FollowLogic
    - 画面清晰度大幅提升，帧率从 45 提升到 48 FPS
2026-05-26 修复 VL53L1X ToF 与 UART3 的 P4 引脚冲突
    - 根因：UART3 TX 和 I2C(2) SCL 共用 P4 引脚
    - UART3 初始化在 I2C(2) 之后时，会重配置 P4 导致 I2C 总线中断
    - 修复：VL53L1X 初始化移至 UART3 之后，I2C(2) 重新获取 P4 SCL 功能
    - ToF 恢复正常（ENODEV 彻底消失），UART3 VIS 输出正常
    [main.py]
2026-05-26 N6 VIS 输出迁移至 P0 软件 UART，解决 P4 引脚冲突
    - 根因：N6 的 UART3 TX 和 I2C(2) SCL 共用 P4，无法共存
    - 方案：VL53L1X 独占 I2C(2) (P4/P5)；VIS 改用 P0 软件 UART (115200 bps)
    - 软件 UART 实测稳定，45 FPS YOLO + ToF 实时读数无冲突
    - 更新引脚映射：N6 VIS→P0 TX, H7 保持 UART3→P4 TX
    - 更新 CLAUDE.md 通信链路和 UART 分配表
2026-05-26 ESP32 VIS 通信调试：确认 Serial2 GPIO16/17 硬件异常
    - 回环测试：Serial2 TX(GPIO17)→RX(GPIO16) 发送24字节收到0字节
    - TX→RX0测试：GPIO17 数据无法通过硬件 UART 发出
    - GPIO5替代测试：同样失败
    - 根因：ESP32-WROOM-32U 的 Serial2 (UART2) 硬件不可用，疑似 GPIO16/17 引脚损坏
    - 临时方案：恢复稳定基线（WiFi+Dashboard），VIS 通信留待后续硬件排查
    - N6 端可正常工作（YOLOv8n 45FPS + VL53L1X ToF + 软件UART P0）
2026-05-26 文档统一同步：ESP8266 桥接方案 + 全项目注释更新
    - CLAUDE.md：新增 ESP8266 桥接层，更新通信链路/N6引脚/UART分配表
    - ROADMAP.md：更新 Phase 0 通信调试结论，ESP8266 VIS+Dashboard 状态
    - ESP32_Solo/Config.h：标注 Serial2 异常，VIS 暂由 ESP8266 代理
    - 新增 ESP8266_Bridge/：VIS 接收 (D5, 4800bd) + WiFi Dashboard (HTTP :80)
    - 通信调试总结：ESP32 Serial2 GPIO16/17 不稳定，ESP8266 SoftwareSerial 通道验证通过
2026-05-26 Phase 0 收尾：全项目文档/代码同步到当前工作状态
    - OpenMV/main.py: P0 SW UART @ 4800 baud, VIS 软件位打发送, P4/P5 I2C(2) ToF 独占
    - ESP8266_Bridge: VIS 接收 D5@4800 + WiFi Dashboard + /status JSON, 97.4% 成功率
    - CLAUDE.md: 新增 ESP8266 桥接层, N6 引脚表, 通信链路更新
    - ROADMAP.md: Phase 0.3 标记完成, 新增 0.3b ESP8266 Bridge 验证, 0.4 硬件清单更新
    - ESP32_Solo/Config.h: UART 表标注 Serial2 异常状态
    - 通信验证: N6 P0→ESP8266 D5 4800bd, 77 帧收 75 帧成功 (97.4%)
2026-05-26 加强版 ESP8266 Dashboard + N6 main.py 烧录部署
    - ESP8266 Dashboard: 新增检测框详情(中心XY/偏航/宽高)、通信帧统计(成功率/总数/成功/失败)、数据时效(age ms)、系统内存/WiFi客户端
    - /status JSON: 新增 age(数据时效), wifi_clients, rx 帧统计(total/ok/fail)
    - N6 main.py: P0 SW UART @ 4800 baud 最终版, 上传至 N6 闪存自启动
    - 当前通信: N6→ESP8266 29帧, 97%成功率
    [ESP8266_Bridge.ino]
2026-05-26 全项目文档同步：README 重写 + ROADMAP Phase 0 标记完成
    - README.md：从旧六轮车方案重写为履带车三层架构，新增 Phase 0 验证结果表、通信协议、目录结构
    - ROADMAP.md：Phase 0 标记核心完成，更新板卡状态和通信方案结论
    - CLAUDE.md：保持最新（之前已更新）
2026-05-26 清理过时文档，全项目注释审计通过
    - 移除 docs/ARCHITECTURE.md (旧六轮车 UniBoard 架构)
    - 移除 docs/WIRING.md (旧超声波/RZ7886 接线)
    - 当前活跃文档: CLAUDE.md, ROADMAP.md, README.md (均已在前期同步)
    - 源代码注释: main.py/ESP8266_Bridge/Config.h/VisionBridge/STM32 (均一致)
2026-05-26 ROADMAP: 新增 0.5b 板间连接器与线束规范，替换杜邦线为工业级方案
2026-05-27 ROADMAP 0.5 重写：整车电气拓扑 + STM32 引脚分配 + ESP8266↔STM32 通信验证
    - 0.5 电气拓扑图重写：修正供电链路（电池→降压模块→控制板, 电池→电调独立）
    - STM32 完整引脚分配（LQFP48 两排脚位图 + 功能分组速查表）
    - ESC 接线详解（PB8/PB9 PWM, 红线不接原因, 电调供电回路）
    - 上电时序与安全逻辑（5步启动 + 急停ISR）
    - ESP8266↔STM32 USART3 双向通信测试通过 (0% 丢包, test_stm32_comm)
    - STM32 main.cpp: PA3 蜂鸣器引脚加注释 (pinMode 触发 USART2 冲突)
    - 新增 机械臂控制主板详解 + STM32 引脚定义图 (硬件参考)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
    [main.cpp, test_stm32_comm.ino]
2026-05-27 重命名: 机械臂控制主板详解 → STM32引脚定义详解
2026-05-28 新增 C06B 主板原理图及分析文档
2026-05-28 架构重构: ESP8266 替代 ESP32 + HC6060A 混控电调 + PS2 手柄 + 蜂鸣器
    - ESP8266 全面替代 ESP32: VIS接收 + FollowLogic + STM32串口 + Dashboard
    - MotorCmd 重构: CarCmd 枚举移除, 改为 {throttle, steering} μs 连续值
    - STM32 FW 从零实现: TIM4 50Hz PWM (PB8转向/PB9油门), USART3 ESP8266通信, 500ms超时
    - PS2 手柄 (WHEELTEC 引脚: PB12=CLK/PB13=CS/PB14=CMD/PB15=DATA), START 解锁/锁定
    - 蜂鸣器 PA3 (经跳线, active-HIGH), ARM=两声短鸣, DISARM=一声长鸣
    - FollowLogic 连续比例输出: throttleFromScore + steeringFromOffset
    - ESP32_Solo/ 标记废弃, 新增 DEPRECATED.md
    - 新增 HC6060A 电调技术参考手册
    - 文档同步: CLAUDE.md,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
2026-05-28 精简 STM32 PS2 控制固件 + 休眠检测 + 安全锁定
    - 移除 ESP8266 全部代码 (Serial3/CRC8/协议处理)
    - 控制器休眠检测: 数据冻结 10s → 自动锁定
    - 上电安全: 显式锁定 + 首次轮询跳过, 防止误触发 ARM
    - 串口输出 5Hz: 方向标注 (FWD/REV/LFT/RGT/STOP)
    - 代码 441→290 行, 未改任何引脚/寄存器定义
2026-05-28 文档同步: ROADMAP 重写 + CLAUDE.md 修正
    - ROADMAP 重写: ESP32→ESP8266, 新增当前进展/安全链路#6, 更新里程碑
    - CLAUDE.md: 修正 ESC PWM 注释(PB8=黄线转向/PB9=白线油门), 安全表新增休眠检测
2026-05-28 新增 SELECT 键切换控制源 (PS2/ESP8266) + ESP 模式禁用休眠检测
    - SELECT (buttons2 bit0) 切换: PS2 手柄模式 ↔ ESP8266 串口模式
    - 切换时自动锁定 + 长鸣, 防止误操作
    - ESP 模式下禁用控制器休眠检测 (手柄不动是正常的)
    - 串口输出增加模式前缀: PS2/ESP
2026-05-29 新增 OLED 128x64 显示 (H2 SPI: PB3/RST PB4/SDIN PB5/SCLK PA15/DC)
    - WHEELTEC 驱动移植到 STM32Duino (寄存器直接访问)
    - 6x12 ASCII 字体, 4 行显示: 模式/ARM/T:S/方向
    - 5Hz 刷新, 帧缓冲 1KB
    - JTAG 禁用释放 PA15 为 GPIO
2026-05-29 强化 PS2 安全: 默认 PS2 模式 + 重连防抖 + OLED 修复
    - setup() 显式设置 g_espMode=false, 每次上电必定 PS2 手动模式
    - PS2 断连/重连时重置 startupSkip=3, 同步 lastStart/lastSel
    - 修复插拔接收器误触发 SELECT 模式切换
    - OLED 状态与串口一致: 无 PS2 时显示 "---"
    - OLED 初始化移至 PS2 之后, 避免 JTAG 禁用干扰 PS2
    [main.cpp]
2026-05-31 动力架构重构: 有刷电调→双路无刷电调 + 坦克混控 + ESP↔STM32 通信打通
    - HC6060A 混控有刷电调废弃, 切换为双路独立三相无刷 ESC (实车电机为无刷)
    - STM32 新增坦克混控: left=thr+(st-1500), right=thr-(st-1500), 钳位 1000-2000
    - PB8=左电机, PB9=右电机 (替代原 黄线转向/白线油门)
    - ESP8266↔STM32 USART3 通信打通: SerialESP(PB11/PB10), CRC8 校验, 6-byte 帧
    - 命令超时改为 PS2/ESP 通用: 500ms 无命令即归中
    - 5Hz 状态输出新增 L/R PWM 值 + OLED 同步显示
    - N6 VIS 输出: bit-bang 软件串口 → P0 硬件 UART(3)
    - WiFi SSID: Rover → Tracked Robot
    - Dashboard: HC6060A → Dual BLDC, 白线/黄线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
2026-05-31 文档同步: 更新进度至 6/1 + N6硬件UART + ESP↔STM32已打通
    - ROADMAP: 日期更新, ESP↔STM32从未完成移至已完成, Phase 1.3/3打勾
    - ROADMAP: 硬件变更记录新增 ESP↔STM32 + N6 HW UART 两行
    - ROADMAP: Phase 2 注明 ESP32 迁移 (ESP8266 UART已满)
    - CLAUDE/README: P0 SW UART → HW UART(3), WiFi Rover → Tracked Robot
2026-06-02 代码修复 + 文档同步: CRH寄存器修正 + 摇杆满幅 + HW限制记录
    - escInit() CRH 位偏移修复: PB8/PB9 正确配置为 AF 推挽输出 (原错误操作 PB12/PB13)
    - 摇杆映射改为满幅 1000-2000μs (移除 MAX_THROTTLE/MAX_STEER 限幅)
    - LOCKED 状态下也输出 PWM, 方便 ESC 编程/校准
    - CLAUDE.md 新增 Known Hardware Limitations 章节 (220Ω + 3.3V 电平)
    - ROADMAP 更新: ZTW Seal G2 调试状态, HW变更记录, 待完成任务
    - ROADMAP 日期更新至 6/2
    [main.cpp]
2026-06-02 STM32 PWM重构: PB8/PB9→PB0/PB1(TIM3) + 中位可调 + LOCKED修复
    - ESC PWM 从 TIM4 PB8/PB9 迁移到 TIM3 PB0/PB1 (H8/H9)
    - PWM_NEUTRAL=1275, MIN=650, MAX=1900 (适配 ZTW Seal G2 行程)
    - 方向判断自动基于 PWM_NEUTRAL ±20μs, 不再硬编码阈值
    - LOCKED 状态恢复严格锁定 (需 g_motorArmed 才输出 PWM)
    - 命令超时 500ms→20s
    - 状态显示钳位改用 PWM_MIN/PWM_MAX 常量, 改一处生效
    [main.cpp]
2026-06-02 文档同步: ZTW Seal G2 中位适配解决 + PWM迁移记录
    - ROADMAP: ZTW ESC 状态 🔴调试中→✅已解决, 记录脉宽中位偏移发现
    - ROADMAP: PWM引脚迁移记录 PB8/PB9→PB0/PB1
    - ROADMAP: 安全超时 500ms→20s
    - CLAUDE: 新增 ZTW 电调 PWM 中位适配章节(核心发现+同类案例)
    - CLAUDE: Known Limitations 更新(C06B H8/H9), Bug修复记录更新
    - CLAUDE: 坦克混控/摇杆映射/安全表注释同步当前代码
2026-06-02 STM32 main.cpp 重构: 参数集中管理 + 无操作超时 + 安全时间调整
    - 所有可调参数前置到文件头, 分 PWM行程/灵敏度/时序安全/硬件引脚 四区
    - 灵敏度参数化为 THR_SENSITIVITY(600)/STR_SENSITIVITY(400), 改参数不用翻代码
    - 超时逻辑修正: 真正无操作60s才锁定 (对比摇杆值而非单纯刷新)
    - 休眠检测: 10s→30s, 无操作超时: 20s→60s
    - 超时触发时显式 g_motorArmed=false + 蜂鸣 + 串口提示
    [main.cpp]
2026-06-02 文档同步: ROADMAP Phase 进度全面更新至 6/2 最新状态
    - PWM: TIM3 PB0/PB1, PWM_NEUTRAL=1275(650-1900), ZTW Seal G2 已解决
    - 安全: 无操作60s锁定/休眠30s锁定/断连立即锁定
    - Phase 0.1/1.1/1.3/1.4/3 全面刷新 checkboxes 和参数
    - 硬件清单: ZTW电调 待采购→已有
    - 数据流/架构/安全链路 同步更新
2026-06-03 ESP32 重新启用: 精简固件 + UART/LED 硬件验证 + 文档同步
    - ESP32_Solo.ino 重写为单线程 loop 架构 (原 FreeRTOS 3-task 架构)
    - 功能匹配 ESP8266: VIS(SoftSerial GPIO4) + FollowLogic + MotorCmd(Serial2) + WiFi Dashboard
    - 删除 8 个废弃文件: DataAggregator, DashboardServer, VisionBridge, ProtocolUtils, index_html
    - Config.h 精简: 移除 CRSF/ELRS/未使用阈值/FreeRTOS, 新增 PIN_VIS_RX=4, PIN_LED=2
    - DEPRECATED.md 重写为"备用 L2 控制器", 含接线对照/烧录注意/LED 行为
    - 硬件验证: UART0/2 四组收发正常, GPIO2 LED active-HIGH 正常, stub loader 需 --no-stub
    - 新增 test_uart/esp32_uart_test.ino 回环测试程序
    - 更新 CLAUD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
2026-06-03 gitignore: 添加 Arduino build/ 目录排除规则
2026-06-03 添加 ESP32 DevKit V1 引脚参考图
2026-06-03 ESP32 WiFi: 发射功率调至最大 20dBm
    esp_wifi_set_max_tx_power(80) 替代默认功率 (通常~10dBm)。
    80 × 0.25 = 20dBm，ESP32 合法上限。
2026-06-03 OpenMV N6 距离估计重写: ToF 主信号 + 视觉备用 + EMA 平滑
    - 新增 tof_to_dist_score(): VL53L1X mm → distScore 分段线性映射
    - 新增 fused_distance(): ToF 融合 + EMA 平滑 (alpha=0.3) + 视觉降级
    - 保留 vision_dist_score(): ToF 无效时的纯视觉备用
    - 可调参数集中: TOF_STOP_MM=500, TOF_NEAR_MM=1000, TOF_MID_MM=2000, TOF_FAR_MM=4000
    - 关键点: 1.5m 映射到 distScore~0.55 (MID 区间), FollowLogic 自然形成距离平衡
2026-06-03 N6: 修复 UART API 兼容性 (STM32N657)
    - UART(3, baud, tx=Pin('P0')) → UART(3, baud): 新版 N6 固件不支持 tx= 关键字参数
    - 移除未使用的 Pin 导入
    [main.py]
2026-06-03 N6 STM32N657 引脚适配: P0→P2 + UART3→UART4 + LED 指示 + ESP32 诊断
    - N6 main.py: P0→P2 (UART4 TX), Pin ALT AF8_UART4 配置, 新增 RGB LED 状态指示
    - ESP32: LED 改为帧翻转心跳, 新增每 5s VIS 诊断输出
    - 文档全量更新: CLAUDE.md/README.md/ROADMAP.md 引脚从 P0/UART3→P2/UART4
    - 根因: STM32N657 官方引脚表 P0 仅 SPI2, P2=UART4 TX, P4/P5=UART3 但被 ToF I2C2 占用
2026-06-03 PWM 参数对齐 STM32: 中位1275 + ESP32自动模式限幅减半
    - ESP32 Config.h: PWM_NEUTRAL=1275, MIN=650, MAX=1900 (与 STM32 C06B 一致)
    - ESP32 自动模式限幅: MAX_THROTTLE_OFFSET=300 (PS2=600的50%), MAX_STEER_OFFSET=200 (PS2=400的50%)
    - ESP8266 Config.h: 同步修正 PWM_NEUTRAL=1275/MIN=650/MAX=1900
    - 修正注释: P0→P2, UART3→UART4, 坦克混控公式引用 PWM_NEUTRAL 变量
    [Config.h]
2026-06-03 参数集中管理: ESP32 Config.h + N6 main.py 配置区重组
    ESP32:
    - Config.h 新增: DEBUG_BAUD, VIS_BAUD, VIS_BUF_SIZE, DIAG_INTERVAL_MS
    - .ino 硬编码数字全部替换为 Config.h 常量引用
    - DIAG_INTERVAL_MS=0 可关闭诊断输出
    N6:
    - 配置区重组为分组注释块: 相机/推理/VIS/距离估计/LED/调试
    - 移除重复的旧注释 (P0/ESP8266)
    - LED_UPDATE_EVERY_N / LED_TOF_LOST_BLINK 提取为常量
2026-06-03 FollowLogic 双向控制: 前进+后退, 1.5m为目标距离
    N6 tof_to_dist_score:
    - 双向对称映射: 0.5=1.5m(停止), <0.5=远(前进), >0.5=近(后退)
    - 新阈值: TOF_STOP_MM=500, TOF_TARGET_MM=1500, TOF_FAR_MM=4000
    - 分段: 500→1500mm(1.0→0.5), 1500→4000mm(0.5→0.0)
    ESP32 FollowLogic:
    - throttleFromScore 重写: 双向油门, centered=NEUTRAL-score
    - 前进(centered>0): PWM_NEUTRAL+offset, 后退(centered<0): PWM_NEUTRAL-offset
    - 新常量: SCORE_NEUTRAL=0.50, SCORE_DEADBAND=0.04, SCORE_STEER_LOCK=0.70, SCORE_HARD_STOP=0.90
    - handleDistScore: 用 SCORE_STEER_LOCK 替代 DIST_SCORE_SLOW 锁定转向
    - handleFeetY: 重映射到新阈值体系
    ESP8266: FollowLogic.cpp/h 同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
2026-06-03 Dashboard 适配双向控制: 1275中位 + 距离条双向着色
    - 车辆状态: 中性改为1275, 新增 FAST_FWD/FAST_REV/SLOW_FWD/SLOW_REV/R/L 标签
    - 距离条: 新增白色目标线(50%), 双向着色(红=近/蓝=远/绿=目标/黄=过渡)
    - 标签: 近/远→后退/1.5m/前进
    - 默认显示值: 1500→1275 μs
2026-06-03 Dashboard 修复: 标签远近反转 + 双向着色 + 标题统一
    - 修复: 距离条标签 近↔远 交换 (0%=远→100%=近, 与填充方向一致)
    - 着色: 红≥0.9/黄≥0.7/绿0.2-0.7/蓝<0.2 (适配双向控制)
    - 标题: Tracked Robot (与WiFi SSID一致)
    - 默认值: 1500→1275 μs
    - 新增 HTTP 请求串口调试输出
    [ESP32_Solo.ino]
2026-06-05 防卡顿: N6 丢帧暂留 + ESP32 丢人缓停
    - 启用 NO_PERSON_STOP_FRAMES=5: 瞬时丢1-5帧时暂留上次已知位置
    - 距离分随丢帧线性衰减, 防止 YOLO 偶发漏检导致急停
    - update(): 丢人后 5 帧内保持油门 + 线性衰减回中位
    - 转向在丢人时归中 (不保留转向)
    - 修复 unsigned 减法溢出 bug
    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
    [FollowLogic.cpp, main.py]
2026-06-05 N6: Kalman2D 替换 EMA — (cx,w) 4状态恒速滤波
    - 新增 Kalman2D 类: 状态 [cx, w, vx, vw], 过程噪声恒速模型, 测量噪声对角
    - 有人时: _kf.update(cx_raw, w_raw) → 滤波 (cx, w) 输入 fused_distance
    - 丢帧时: _kf.predict_pos() 外推 + 距离分衰减, 无需 _last_* 暂留变量
    - 移除: TOF_SMOOTH_ALPHA, _smooth_score, EMA 平滑链, 旧暂留变量
    - Kalman 参数: dt=25ms, q_pos=5, q_vel=50, r_cx=9px, r_w=25px
2026-06-08 N6: Kalman2D 回退为 EMA + 丢帧暂留 — 简化滤波, 修复外推发散
    [main.py]
2026-06-09 fix: N6 CSI.snapshot() 不支持 time= 参数, 改用 sleep_ms + snapshot
    [main.py]
2026-06-10 docs: ESP32 主控制器, ESP8266 下位备用 — 全项目文档/注释同步
    所有文档、注释、Dashboard 统一反映当前硬件架构:
    ESP32-WROOM-32U 为 L2 主控制器 (2026-06-03 重新启用),
    ESP8266 NodeMCU V3 保留为下位备用硬件。
    同步修正 PWM 参数 (中位 1275, 范围 650-1900),
    Dashboard 标签远近反转, 坦克混控公式等过时描述。
    [Config.h, ESP32_Solo.ino, ESP8266_Bridge.ino, FollowLogic.h, FollowLogic_test.cpp, main.cpp, main.py]
